open-respiratory-monitor/project-documents/README.md

# project-documents
Homepage for Open Respiratory Monitor
Please see the wiki homepage for project documentation here: https://github.com/open-respiratory-monitor/project-documents/wiki
