open-respiratory-monitor/project-documents/mechanical/README.md

Landing place for all mechanical component designs for custom parts.
