open-respiratory-monitor/project-documents/system_overview/cad_screenshot_042720.png

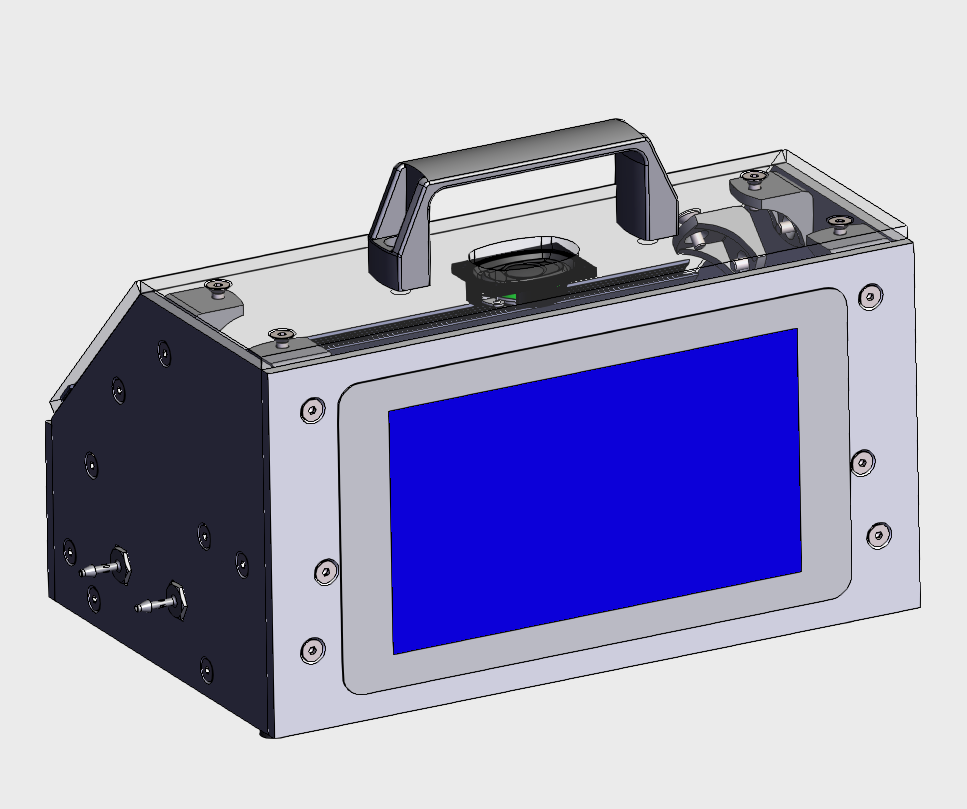
system_overview/cad_screenshot_042720.png
