open-respiratory-monitor/project-documents/parts_list/Monitor Shopping List Rev A - 050120.xlsx

Required Parts per Unit
Total Cost Per Unit = | $877.96
COTS Components
Total Cost Per Unit = | $299.78
Subsystem | Item Number | Description | Mfg Part Number | Mfg | Supplier | Supplier Part Num | Package Cost | Units Per Package | Cost per Item | Quantity | Part Link | Documentation Link | Notes | Line Cost
Alarm | 1 | 4 Ohm 3W Speaker | AS04004PO-2-R | PUI Audio, Inc. | DigiKey | 668-1234-ND | $4.74 | 1 | $4.74 | 1 | https://www.digikey.com/product-detail/en/pui-audio-inc/AS04004PO-2-R/668-1234-ND/1745528 |  | CAD models available on DigiKey | $4.74
Alarm | 2 | Analog Mono Audio Amplifier | 2130 | Adafruit | DigiKey | 1528-1492-ND | $3.95 | 1 | $3.95 | 1 | https://www.digikey.com/products/en?mpart=2130&v=1528 | https://www.adafruit.com/product/2130 |  | $3.95
Alarm | 3 | PCB Mount Audio Jack | STX-3120-5B | Kycon, Inc. | DigiKey | 2092-STX-3120-5B-ND | $0.73 | 1 | $0.73 | 1 | https://www.digikey.com/product-detail/en/kycon-inc/STX-3120-5B/2092-STX-3120-5B-ND/9990114 |  | all of a sudden they're sold out... need replacement | $0.73
Power | 4 | 120 V Receptacle with On/Off Switch | 1-1609112-2 | TE Connectivity Corcom Filters | DigiKey | CCM1916-ND | $11.13 | 1 | $11.13 | 1 | https://www.digikey.com/product-detail/en/te-connectivity-corcom-filters/1-1609112-2/CCM1916-ND/2292077 |  | kind of frustrating to solder | $11.13
Power | 5 | Battery Charger + Switchover Electronics | 2465 | Adafruit | DigiKey | 1528-1349-ND | $19.95 | 1 | $19.95 | 1 | https://www.digikey.com/products/en?mpart=2465&v=1528 | https://learn.adafruit.com/adafruit-powerboost-1000c-load-share-usb-charge-boost/pinouts | haven't tested much | $19.95
Power | 6 | Breakout Hat Protoboard | 2314 | Adafruit | DigiKey | 1528-1370-ND | $7.50 | 1 | $7.50 | 1 | https://www.digikey.com/products/en?mpart=2314&v=1528 | https://www.adafruit.com/product/2314#technical-details | replace with custom PCB | $7.50
Power | 7 | 3.7V Lithium-Ion Battery 6.27 Ah | 353 | Adafruit | DigiKey | 1528-1835-ND | $29.50 | 1 | $29.50 | 1 | https://www.digikey.com/product-detail/en/adafruit-industries-llc/353/1528-1835-ND/5054549 |  |  | $29.50
Power | 8 | 2x20 IDC Stacking Header | 2223 | Adafruit | DigiKey | 1528-1385-ND | $2.50 | 1 | $2.50 | 1 | https://www.digikey.com/product-detail/en/adafruit-industries-llc/2223/1528-1385-ND/5629433 |  |  | $2.50
Power | 9 | 120 VAC to 5 VDC Converter (15W) | RS-15-5 | Mean Well USA Inc. | DigiKey | 1866-4133-ND | $9.57 | 1 | $9.57 | 1 | https://www.digikey.com/product-detail/en/mean-well-usa-inc/RS-15-5/1866-4133-ND/7706168 | https://www.meanwell.com/Upload/PDF/RS-15/RS-15-SPEC.PDF |  | $9.57
Power | 10 | Fan 5VDC 40x40x20 mm | G4020H05B-RSR | Mechatronics Fan Group | DigiKey | 1570-1085-ND | $7.73 | 1 | $7.73 | 1 | https://www.digikey.com/product-detail/en/mechatronics-fan-group/G4020H05B-RSR/1570-1085-ND/5209782 |  |  | $7.73
Readout | 11 | Microprocessor | Raspberry Pi 4 Model B | Raspberry Pi | DigiKey | 1690-RASPBERRYPI4B/4GB-ND | $67.65 | 1 | $67.65 | 1 | https://www.digikey.com/product-detail/en/raspberry-pi/RASPBERRY%2520PI%25204B%2F4GB/1690-RASPBERRYPI4B%2F4GB-ND/10258781 |  | prototype using a pi3 | $67.65
Readout | 12 | LCD Screen | 8997466 | Raspberry Pi | DigiKey | 1690-1007-ND | $79.00 | 1 | $79.00 | 1 | https://www.digikey.com/product-detail/en/raspberry-pi/8997466/1690-1007-ND/6152806 | https://github.com/raspberrypi/documentation/tree/master/hardware/display |  | $79.00
Readout | 13 | 5-Pin Header Cable for LCD Power | IDSS-05-S-05.75-T-ST4 | Samtec | DigiKey | SAM8931-ND | $3.25 | 1 | $3.25 | 1 | https://www.digikey.com/product-detail/en/samtec-inc/IDSS-05-S-05.75-T-ST4/SAM8931-ND/2685128 |  |  | $3.25
Readout | 14 | USB Panel Mount Recept. | 908 | Adafruit | DigiKey | 1528-1571-ND | $3.95 | 1 | $3.95 | 1 | https://www.digikey.com/product-detail/en/adafruit-industries-llc/908/1528-1571-ND/5844685 |  |  | $3.95
Readout | 15 | Ethernet Panel Mount Recept. | 909 | Adafruit | DigiKey | 1528-1572-ND | $4.95 | 1 | $4.95 | 1 | https://www.digikey.com/product-detail/en/adafruit-industries-llc/909/1528-1572-ND/5844686 |  |  | $4.95
Sensor | 16 | LPS33HW Pressure Sensor Board | 4414 | Adafruit | Adafruit | 4414 | $12.50 | 1 | $12.50 | 2 | https://www.adafruit.com/product/4414 | https://learn.adafruit.com/lps35hw-water-resistant-pressure-sensor | not in stock on digikey, only avail. from adafruit directly -- specify that it's for Covid-19 related issues | $25.00
Sensor | 17 | 1/8 Tube to 1/8" NPT Barbs |  |  | McMaster-Carr | 5463k438 | $10.53 | 10 | $1.05 | 2 | https://www.mcmaster.com/5463k438/ |  | WARNING -- haven't tested these out yet with the O2 tubing | $2.11
Sensor | 18 | Spirometer Mouthpiece for IQSpiro | Smartsense | sdi | A-M Systems Inc. | 165725 | $62.00 | 25 | $2.48 | 1 | https://www.a-msystems.com/p-1474-sdi-diagnostics-smartsense-flow-sensor-for-midmark-iqspiro-spirometer.aspx |  | really need as many as you plan on having patients!! | $2.48
Sensor | 19 | 30 mm to 22 mm Mouthpiece Adapter |  |  | Mainline Medical | 3-1920-00 | $5.95 | 1 | $5.95 | 2 | http://www.mainlinemedical.com/mm/Reducing-Adapter-30mm-OD-22mm-ID.html |  | to adapt the mouthpiece to standard respiratory circuit. Is this something that's in hosptials? | $11.90
Sensor | 20 | Oxygen Tubing |  |  | A-M Systems Inc. |  | $36.12 | 50 | $0.72 | 2 | https://www.a-msystems.com/p-580-oxygen-tubing.aspx |  |  | $1.44
Sensor | 21 | 2x20 IDC Box Header | 1993 | Adafruit | DigiKey | 1993-ND | $0.75 | 1 | $0.75 | 1 | https://www.digikey.com/products/en?keywords=2x20%20idc%20box%20header |  |  | $0.75
Custom Components
Total Cost Per Unit = | $578.18
Subsystem | Item Number | Description | Vendor | Material | Mfg Method | Lead Time | Order Cost | Parts per Order | Cost per Item | Quantity |  |  | Notes
Sensor | 22 | Sensor PCB | Sunstone CIrcuits | PCB |  | 1 week | $324.50 | 10 | $32.45 | 1 |  |  | Custom board reads out two Adafruit LPS33HW modules. May make custom board with populated components for final version | $32.45
Sensor | 23 | Power Breakout Board | Sunstone Circuits | PCB |  | 1 week | $324.00 | 10 | $32.40 | 1 |  |  | Handmade board for prototype. Will eventually be a PCB for the final version. Cost shown is estimate. | $32.40
Sensor | 24 | Flowmeter Housing | Protolabs | Acrylic | Machined | 3 day | $983.30 | 10 | $98.33 | 1 |  |  | 3D printed for prototype. Will be machined acrylic for final version | $98.33
System | 25 | Monitor Enclosure | Statasys | Vero (white) | 3D Printed (PolyJet) | 1 week | $415.00 | 1 | $415.00 | 1 |  |  | 3D printed for prototype, investigating sheet metal and machined acrylic panels for final version | $415.00
