open-respiratory-monitor/project-documents/parts_list/README.md

Parts list for monitor unit describing all necessary electrical and mechanical components and identifying commercial vendors.
