open-respiratory-monitor/project-documents/system_overview/Vent Monitor Overview Rev5.pdf

## Raspberry Pi Using a 3, but probably

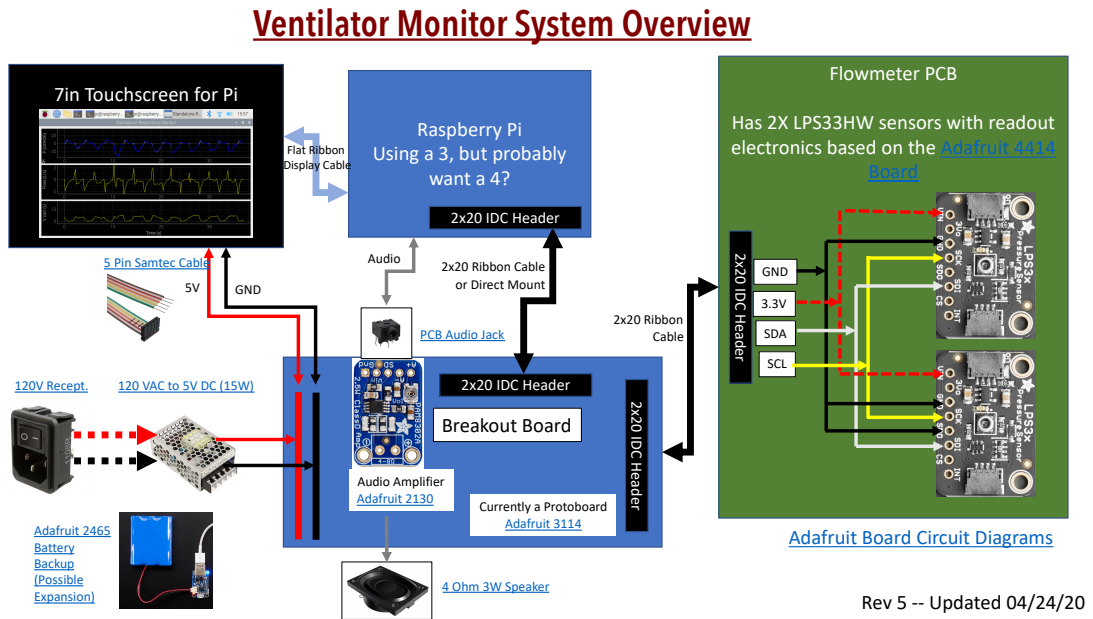
[picture p2: page 1]
want a 4?; Flowmeter PCB; Board; Audio; Audio Amplifier Adafruit 2130; 4 Ohm 3W Speaker; 2x20 IDC Header; Flat Ribbon Display Cable; GND; 120V Recept.; Adafruit 2465 Battery Backup (Possible Expansion); Breakout Board; SDA; SCL; Rev 5 -- Updated 04/24/20; 2x20 Ribbon Cable; Currently a Protoboard Adafruit 3114

Ventilator Monitor System Overview

7in Touchscreen for Pi

Has 2X LPS33HW sensors with readout
electronics based on the Adafruit 4414

5 Pin Samtec Cable (https://www.digikey.com/product-detail/en/samtec-inc/IDSS-05-S-05.75-T-ST4/SAM8931-ND/2685128)

2x20 Ribbon Cable
or Direct Mount

PCB Audio Jack (https://www.digikey.com/product-detail/en/kycon-inc/STX-3120-5B/2092-STX-3120-5B-ND/9990114)

120 VAC to 5V DC (15W) (https://www.digikey.com/product-detail/en/mean-well-usa-inc/RS-15-5/1866-4133-ND/7706168)

Adafruit Board Circuit Diagrams (https://learn.adafruit.com/lps35hw-water-resistant-pressure-sensor/downloads)
