open-respiratory-monitor/project-documents/(commit log)

2020-05-01 added pcb layout files
    [Ventilator_Monitor-B_Cu.gbr, Ventilator_Monitor-B_Mask.gbr, Ventilator_Monitor-B_Paste.gbr, Ventilator_Monitor-B_SilkS.gbr, Ventilator_Monitor-Edge_Cuts.gbr, Ventilator_Monitor-F_Cu.gbr, Ventilator_Monitor-F_Mask.gbr, Ventilator_Monitor-F_Paste.gbr]
2020-05-01 added shopping list
    [Monitor Shopping List Rev A - 050120.xlsx]
